tuengominh/esp32-dragon/esp32-dragon/kicad/ESP32-sensor/ESP32-sensor.kicad_pcb

## KiCad design esp32-dragon/kicad/ESP32-sensor/ESP32-sensor.kicad_pcb (2020-11-24)

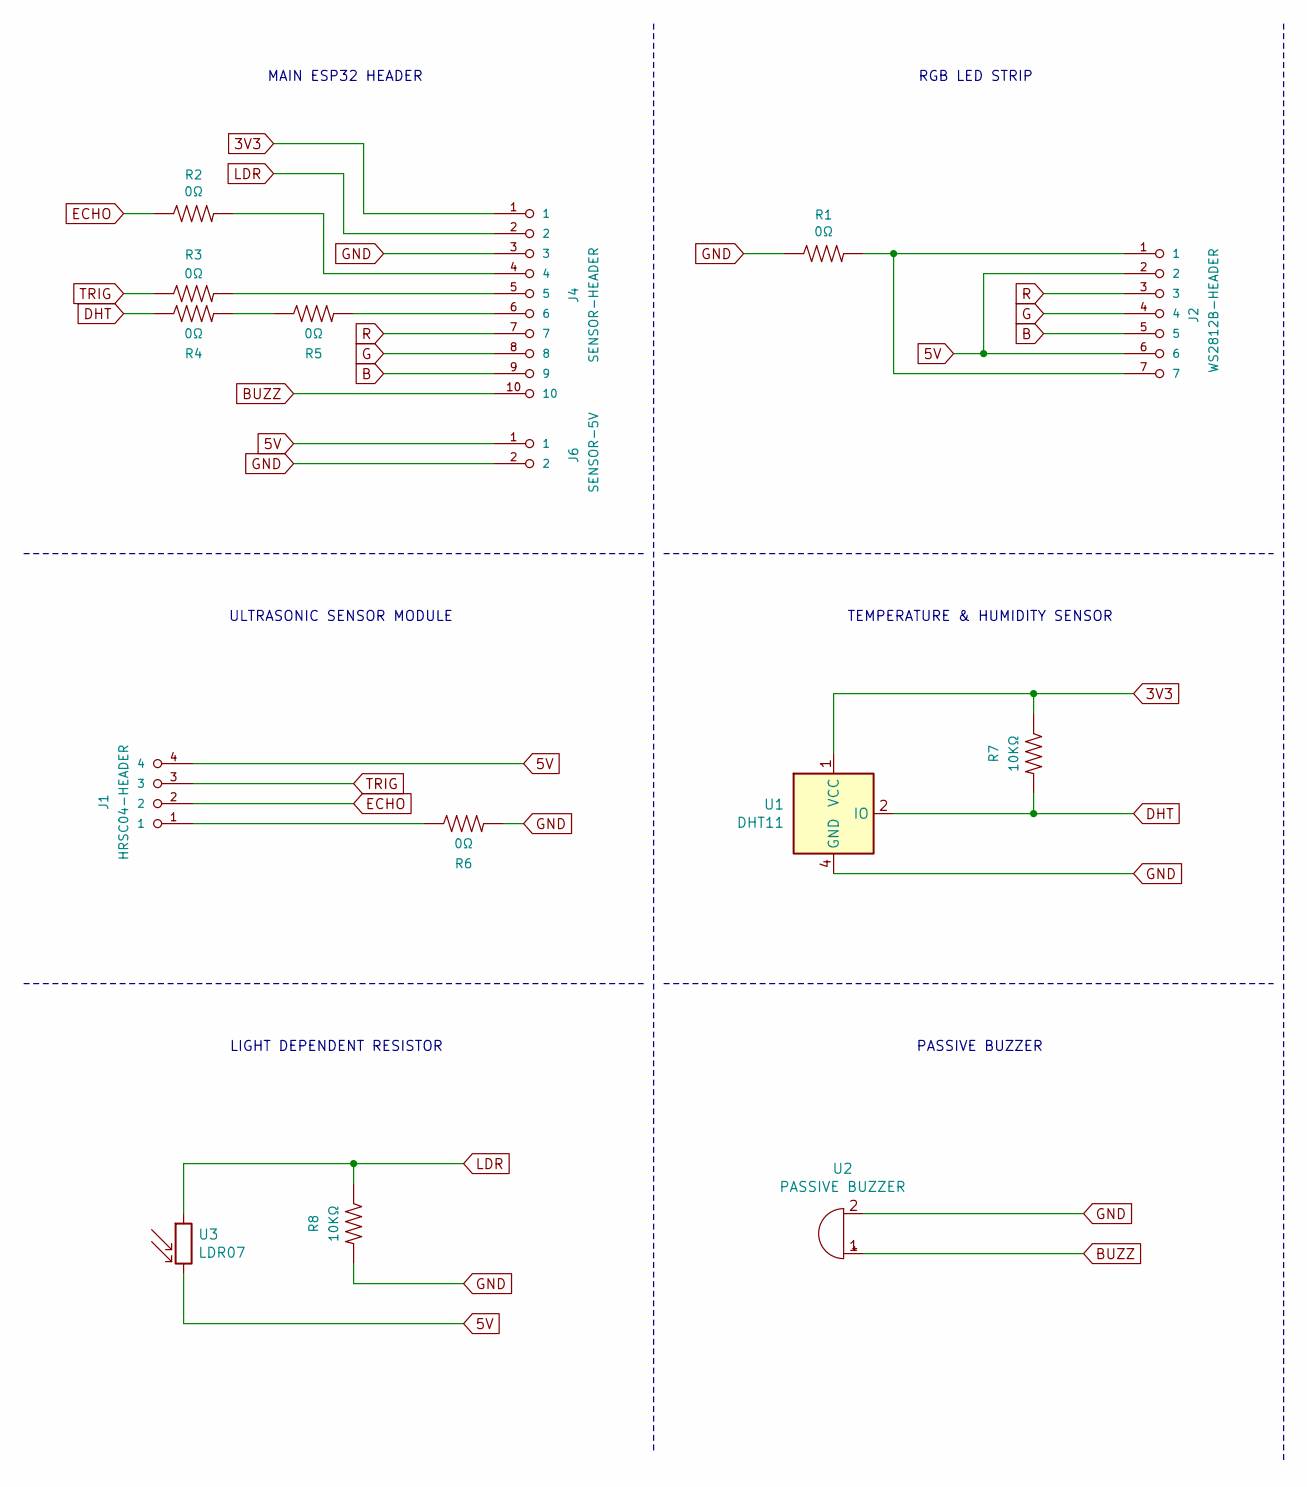
[picture p1: schematic ESP32-sensor.sch]

Parts:
J1: HRSC04-HEADER; fab-1X04
J2: WS2812B-HEADER; fab-1X07
J4: SENSOR-HEADER; fab-1X10
J6: SENSOR-5V; fab-1X02
R1, R2, R3, R4, R5, R6: 0Ω; fab-R1206FAB
R7, R8: 10KΩ; fab-R1206FAB
U1: DHT11; Aosong_DHT11_5.5x12.0_P2.54mm
U2: PASSIVE BUZZER; Buzzer_12x9.5RM7.6
U3: LDR07; R_LDR_5.1x4.3mm_P3.4mm_Vertical

Connections:
3V3: J4.1, R7.1, U1.1 (VCC)
5V: J1.4, J2.2, J2.6, J6.1, U3.2
B: J2.5, J4.9
BUZZ: J4.10, U2.1 (-)
DHT: R4.1, R7.2, U1.2 (IO)
ECHO: J1.2, R2.1
G: J2.4, J4.8
GND: J4.3, J6.2, R1.1, R6.2, R8.2, U1.4 (GND), U2.2 (+)
LDR: J4.2, R8.1, U3.1
unnamed: J1.1, R6.1
unnamed: J2.1, J2.7, R1.2
unnamed: J4.4, R2.2
unnamed: J4.5, R3.2
unnamed: J4.6, R5.2
unnamed: R4.2, R5.1
R: J2.3, J4.7
TRIG: J1.3, R3.1

Notes on the sheet:
MAIN ESP32 HEADER
RGB LED STRIP
ULTRASONIC SENSOR MODULE
TEMPERATURE & HUMIDITY SENSOR
PASSIVE BUZZER
LIGHT DEPENDENT RESISTOR

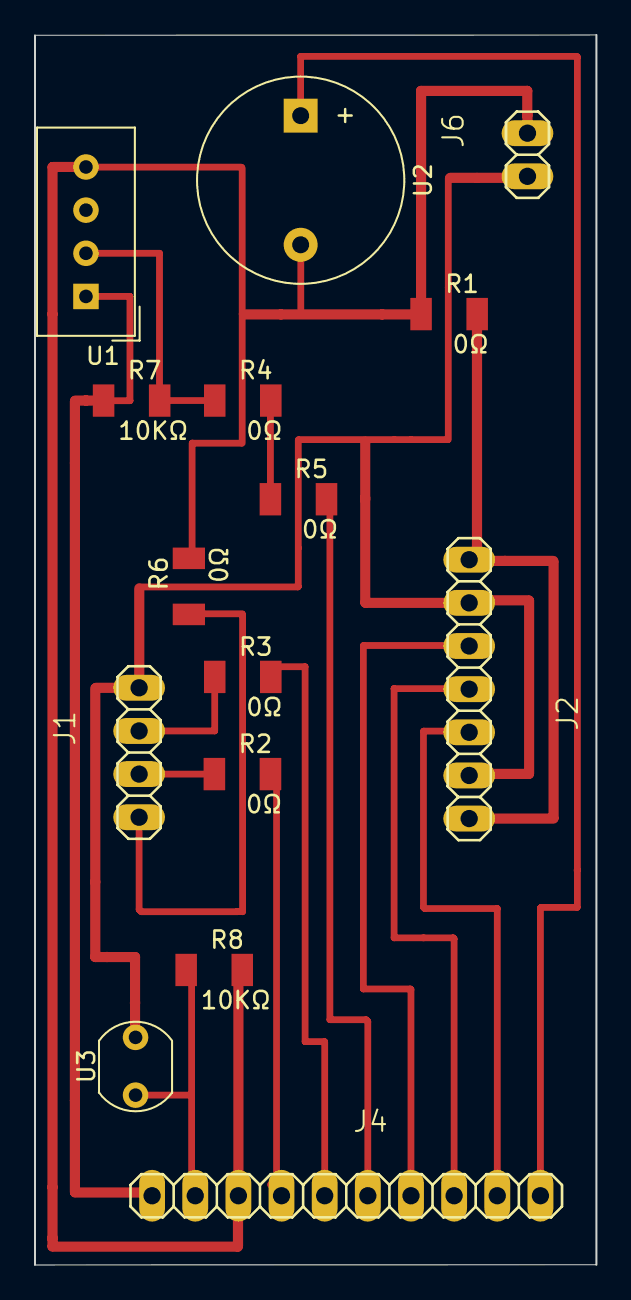
[picture p2: board ESP32-sensor.kicad_pcb from above]

Board: 2 copper layers, 33.1 x 72.4 mm, 15 parts (0 on the bottom side), 17 nets.
