tuengominh/esp32-dragon/esp32-dragon/kicad/ESP8266/ESP8266.kicad_pcb

## KiCad design esp32-dragon/kicad/ESP8266/ESP8266.kicad_pcb (2020-11-24)

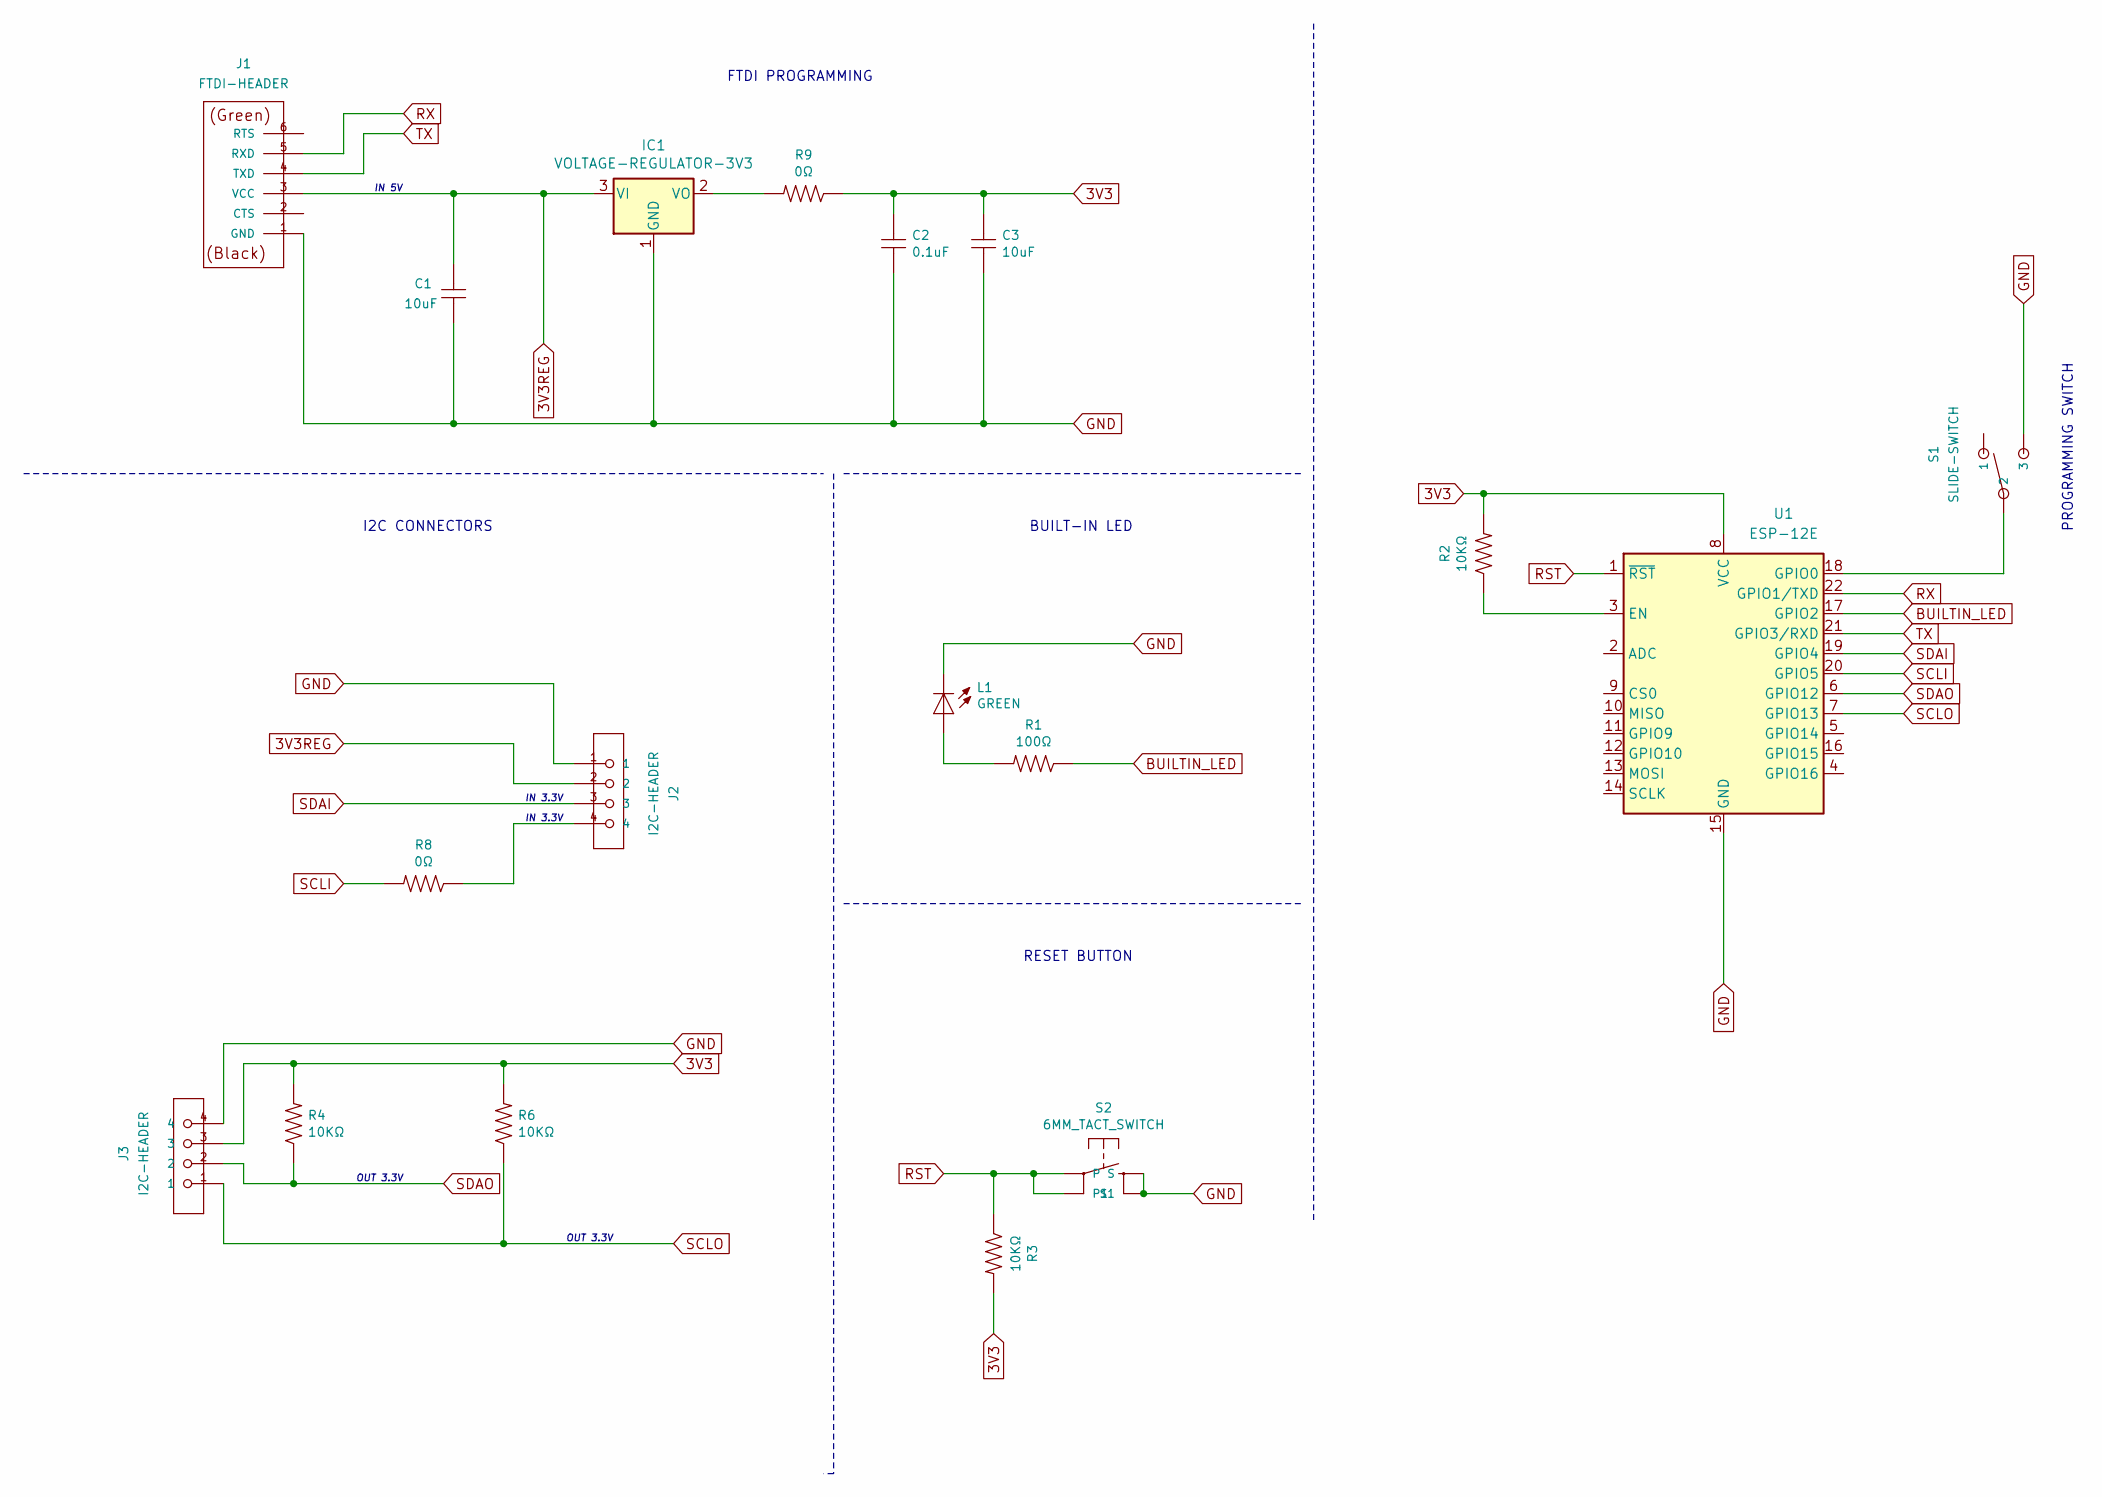
[picture p3: schematic ESP8266.sch]

Parts:
C1, C3: 10uF; fab-C1206FAB
C2: 0.1uF; fab-C1206FAB
IC1: VOLTAGE-REGULATOR-3V3; fab-SOT223
J1: FTDI-HEADER; fab-1X06SMD
J2, J3: I2C-HEADER; fab-1X04SMD
L1: GREEN; fab-LED1206FAB
R1: 100Ω; fab-R1206FAB
R2, R3, R4, R6: 10KΩ; fab-R1206FAB
R8, R9: 0Ω; fab-R1206FAB
S1: SLIDE-SWITCH; fab-AYZ0102AGRLC
S2: 6MM_TACT_SWITCH; fab-6MM_SWITCH
U1: ESP-12E

Connections:
3V3: C2.1, C3.1, J3.3, R2.2, R3.2, R4.2, R6.2, R9.1, U1.8 (VCC)
3V3REG: C1.1, IC1.3 (VI), J1.3 (VCC), J2.2
BUILTIN_LED: R1.1, U1.17 (GPIO2)
GND: C1.2, C2.2, C3.2, IC1.1 (GND), J1.1 (GND), J2.1, J3.4, L1.2 (C), S1.3, S2.3 (S), S2.4 (S1), U1.15 (GND)
unnamed: IC1.2 (VO), R9.2
unnamed: J2.4, R8.1
unnamed: L1.1 (A), R1.2
unnamed: R2.1, U1.3 (EN)
unnamed: S1.2, U1.18 (GPIO0)
RST: R3.1, S2.1, S2.2 (P1), U1.1 (~RST)
RX: J1.5 (RXD), U1.22 (GPIO1/TXD)
SCLI: R8.2, U1.20 (GPIO5)
SCLO: J3.1, R6.1, U1.7 (GPIO13)
SDAI: J2.3, U1.19 (GPIO4)
SDAO: J3.2, R4.1, U1.6 (GPIO12)
TX: J1.4 (TXD), U1.21 (GPIO3/RXD)

Notes on the sheet:
FTDI PROGRAMMING
IN 5V
RESET BUTTON
BUILT-IN LED
OUT 3.3V
I2C CONNECTORS
PROGRAMMING SWITCH
IN 3.3V

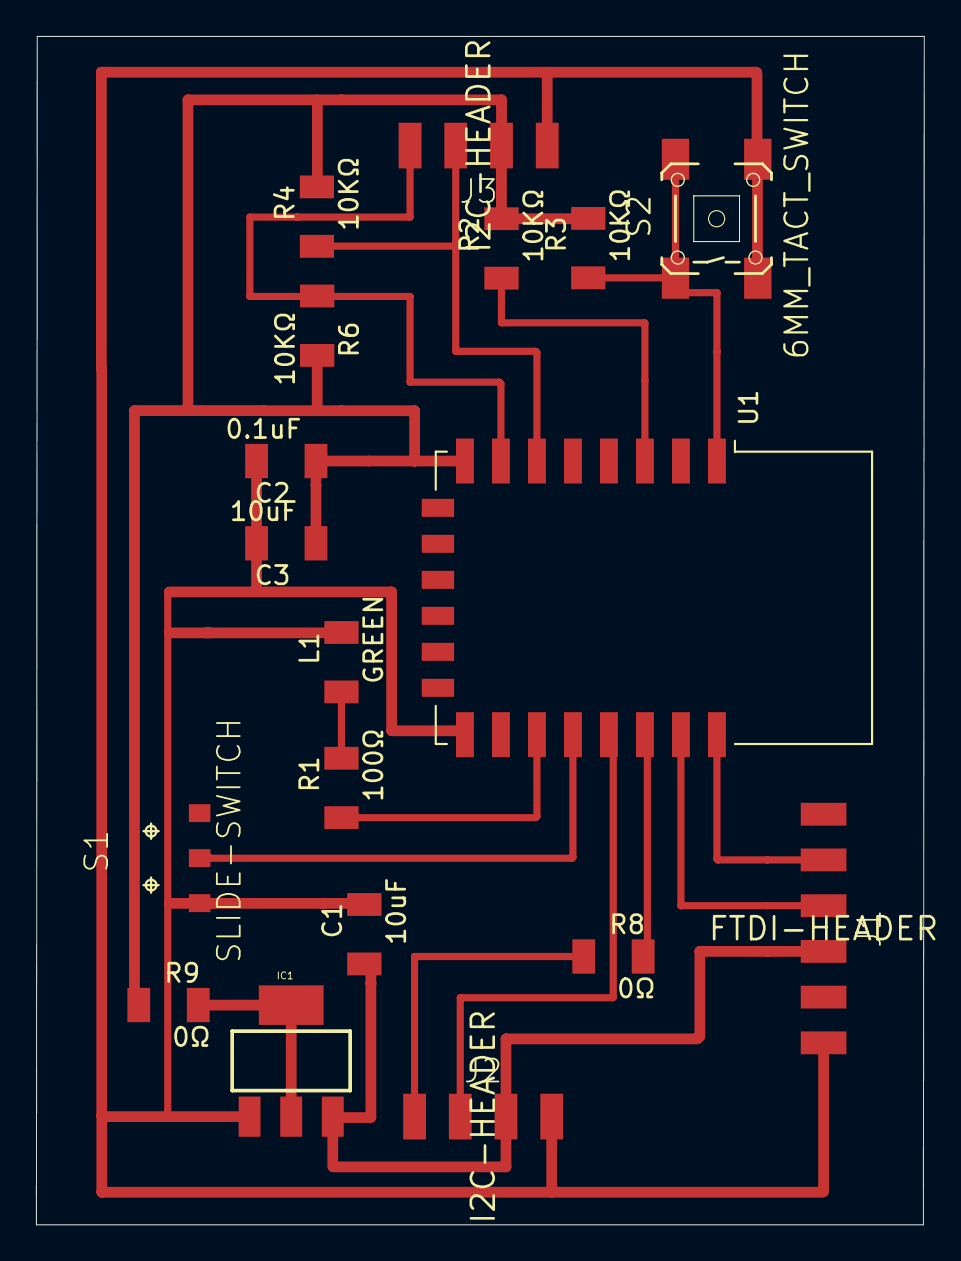
[picture p4: board ESP8266.kicad_pcb from above]

Board: 2 copper layers, 49.3 x 66.0 mm, 18 parts (0 on the bottom side), 16 nets.
