tuengominh/esp32-dragon/esp32-dragon/kicad/ESP32-motor/ESP32-motor.kicad_pcb

## KiCad design esp32-dragon/kicad/ESP32-motor/ESP32-motor.kicad_pcb (2020-11-24)

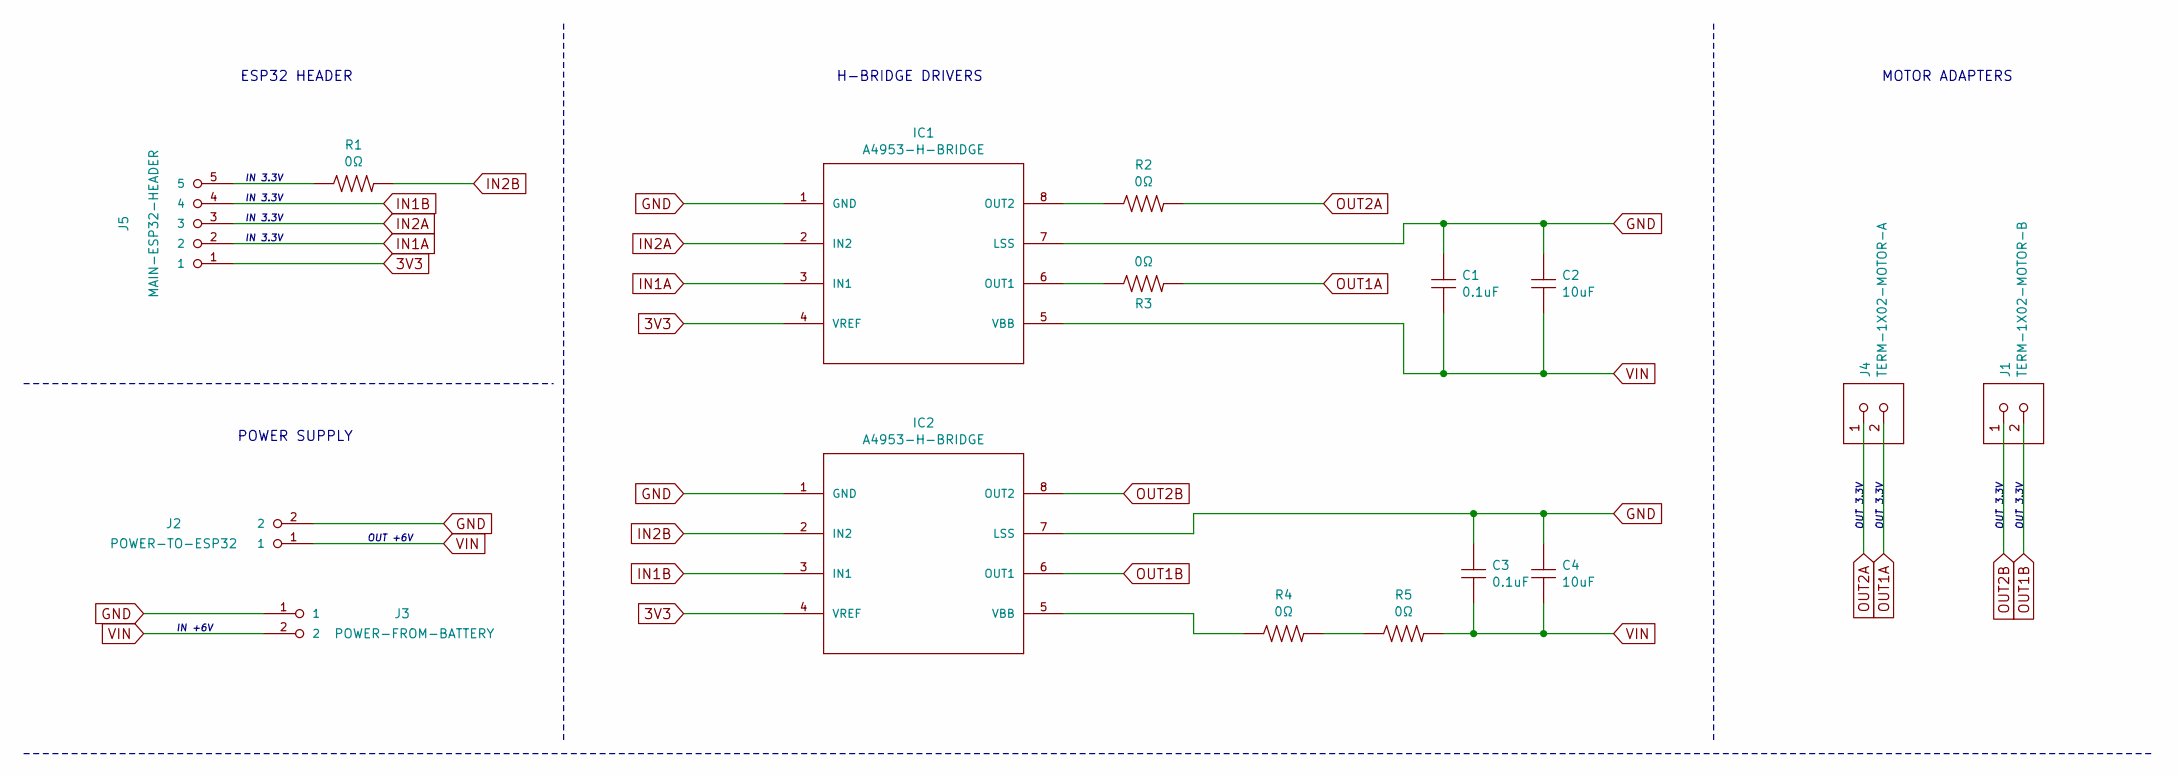
[picture p5: schematic ESP32-motor.sch]

Parts:
C1, C3: 0.1uF; fab-C1206FAB
C2, C4: 10uF; fab-C1206FAB
IC1, IC2: A4953-H-BRIDGE; fab-SOIC8
J1: TERM-1X02-MOTOR-B; fab-ED555DS-2DS
J2: POWER-TO-ESP32; fab-1X02
J3: POWER-FROM-BATTERY; HW2-SMD-2.0-90D
J4: TERM-1X02-MOTOR-A; fab-ED555DS-2DS
J5: MAIN-ESP32-HEADER; fab-1X05
R1, R2, R3, R4, R5: 0Ω; fab-R1206FAB

Connections:
3V3: IC1.4 (VREF), IC2.4 (VREF), J5.1
GND: C1.2, C2.2, C3.2, C4.2, IC1.1 (GND), IC1.7 (LSS), IC2.1 (GND), IC2.7 (LSS), J2.2, J3.1
IN1A: IC1.3 (IN1), J5.2
IN1B: IC2.3 (IN1), J5.4
IN2A: IC1.2 (IN2), J5.3
IN2B: IC2.2 (IN2), R1.2
unnamed: IC1.6 (OUT1), R3.1
unnamed: IC1.8 (OUT2), R2.1
unnamed: IC2.5 (VBB), R4.1
unnamed: J5.5, R1.1
unnamed: R4.2, R5.1
OUT1A: J4.2, R3.2
OUT1B: IC2.6 (OUT1), J1.2
OUT2A: J4.1, R2.2
OUT2B: IC2.8 (OUT2), J1.1
VIN: C1.1, C2.1, C3.1, C4.1, IC1.5 (VBB), J2.1, J3.2, R5.2

Notes on the sheet:
ESP32 HEADER
POWER SUPPLY
H-BRIDGE DRIVERS
MOTOR ADAPTERS
OUT +6V
IN +6V
IN 3.3V
OUT 3.3V

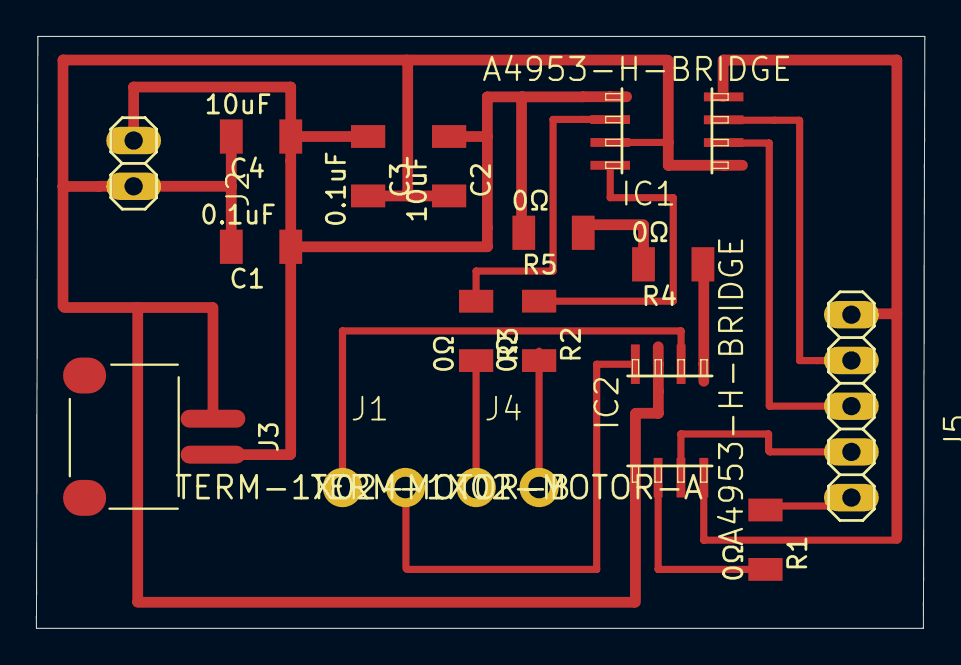
[picture p6: board ESP32-motor.kicad_pcb from above]

Board: 2 copper layers, 49.4 x 32.9 mm, 16 parts (0 on the bottom side), 16 nets.
