tuengominh/esp32-dragon/esp32-dragon/kicad/ESP32-v3/ESP32-main.kicad_pcb

## KiCad design esp32-dragon/kicad/ESP32-v3/ESP32-main.kicad_pcb (2020-11-24)

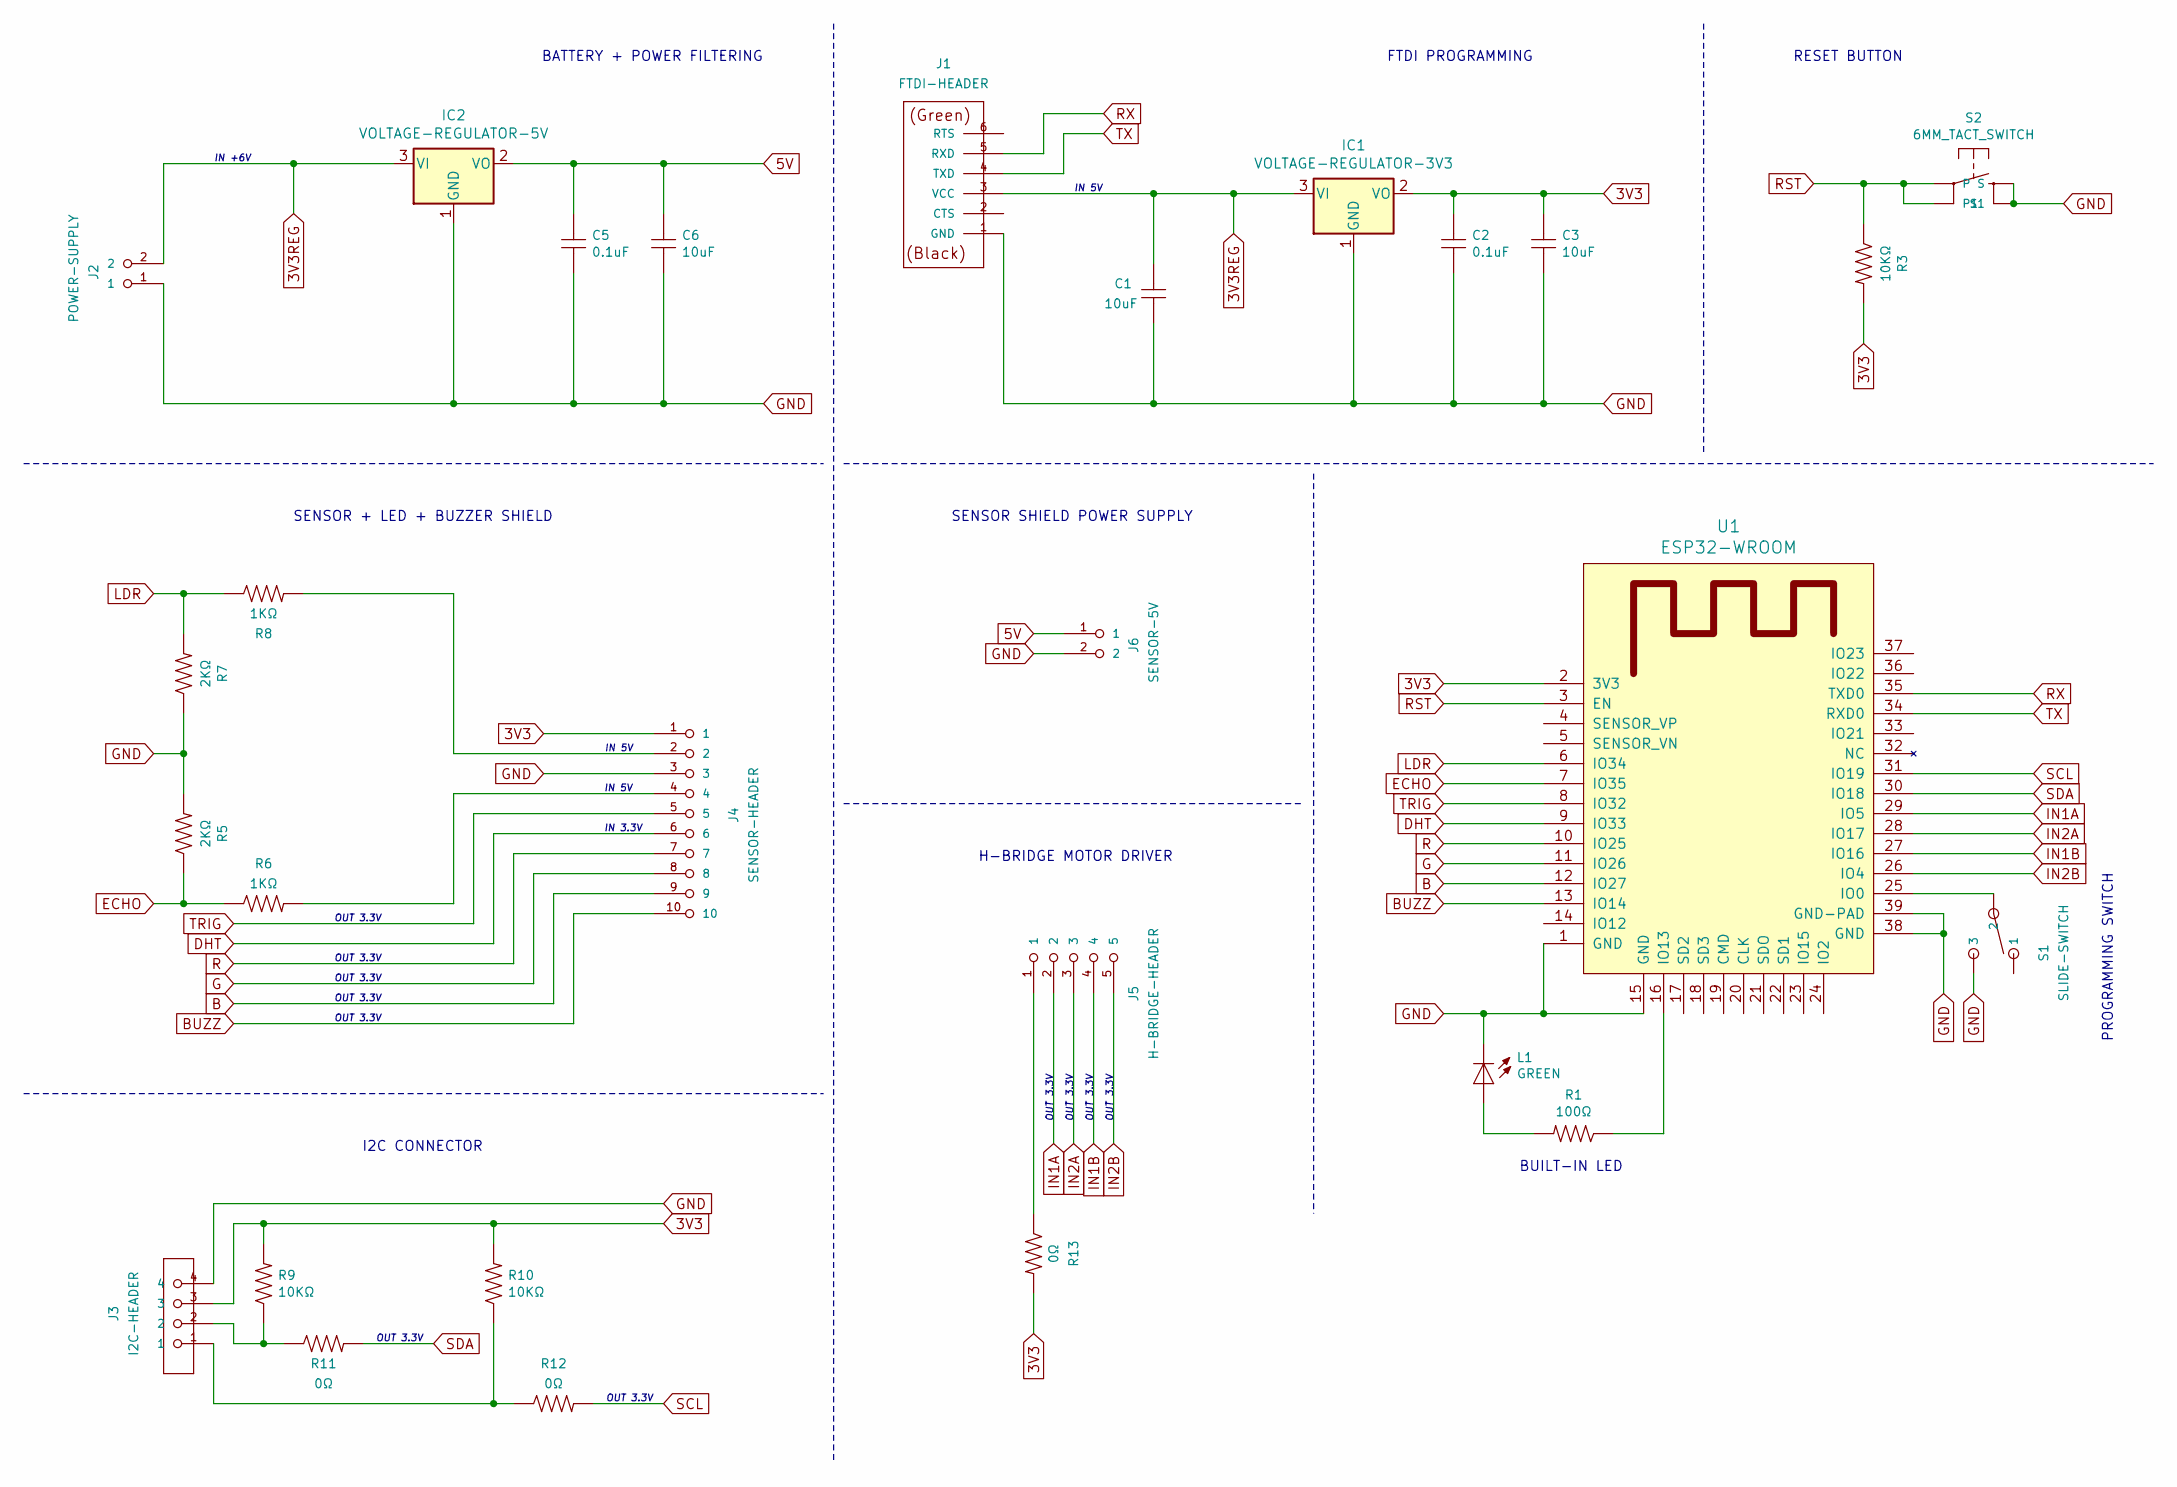
[picture p7: schematic ESP32-main.sch]

Parts:
C1, C3, C6: 10uF; fab-C1206FAB
C2, C5: 0.1uF; fab-C1206FAB
IC1: VOLTAGE-REGULATOR-3V3; fab-SOT223
IC2: VOLTAGE-REGULATOR-5V; fab-SOT223
J1: FTDI-HEADER; fab-1X06SMD
J2: POWER-SUPPLY; fab-1X02
J3: I2C-HEADER; fab-1X04SMD
J4: SENSOR-HEADER; fab-1X10
J5: H-BRIDGE-HEADER; fab-1X05
J6: SENSOR-5V; fab-1X02
L1: GREEN; fab-LED1206FAB
R1: 100Ω; fab-R1206FAB
R3, R9, R10: 10KΩ; fab-R1206FAB
R5, R7: 2KΩ; fab-R1206FAB
R6, R8: 1KΩ; fab-R1206FAB
R11, R12, R13: 0Ω; fab-R1206FAB
S1: SLIDE-SWITCH; fab-AYZ0102AGRLC
S2: 6MM_TACT_SWITCH; fab-6MM_SWITCH
U1: ESP32-WROOM; ESP32-WROOM_FAB

Connections:
3V3: C2.1, C3.1, IC1.2 (VO), J3.3, J4.1, R3.2, R9.2, R10.2, R13.2, U1.2 (3V3)
3V3REG: C1.1, IC1.3 (VI), IC2.3 (VI), J1.3 (VCC), J2.2
5V: C5.1, C6.1, IC2.2 (VO), J6.1
B: J4.9, U1.12 (IO27)
BUZZ: J4.10, U1.13 (IO14)
DHT: J4.6, U1.9 (IO33)
ECHO: R5.1, R6.1, U1.7 (IO35)
G: J4.8, U1.11 (IO26)
GND: C1.2, C2.2, C3.2, C5.2, C6.2, IC1.1 (GND), IC2.1 (GND), J1.1 (GND), J2.1, J3.4, J4.3, J6.2, L1.2 (C), R5.2, R7.1, S1.3, S2.3 (S), S2.4 (S1), U1.1 (GND), U1.15 (GND), U1.38 (GND), U1.39 (GND-PAD)
IN1A: J5.2, U1.29 (IO5)
IN1B: J5.4, U1.27 (IO16)
IN2A: J5.3, U1.28 (IO17)
IN2B: J5.5, U1.26 (IO4)
LDR: R7.2, R8.1, U1.6 (IO34)
unnamed: J3.1, R10.1, R12.1
unnamed: J3.2, R9.1, R11.1
unnamed: J4.2, R8.2
unnamed: J4.4, R6.2
unnamed: J5.1, R13.1
unnamed: L1.1 (A), R1.2
unnamed: R1.1, U1.16 (IO13)
unnamed: S1.2, U1.25 (IO0)
R: J4.7, U1.10 (IO25)
RST: R3.1, S2.1, S2.2 (P1), U1.3 (EN)
RX: J1.5 (RXD), U1.35 (TXD0)
SCL: R12.2, U1.31 (IO19)
SDA: R11.2, U1.30 (IO18)
TRIG: J4.5, U1.8 (IO32)
TX: J1.4 (TXD), U1.34 (RXD0)

Notes on the sheet:
FTDI PROGRAMMING
IN 5V
BATTERY + POWER FILTERING
RESET BUTTON
I2C CONNECTOR
PROGRAMMING SWITCH
BUILT-IN LED
H-BRIDGE MOTOR DRIVER
OUT 3.3V
IN 3.3V
SENSOR + LED + BUZZER SHIELD
SENSOR SHIELD POWER SUPPLY
IN +6V

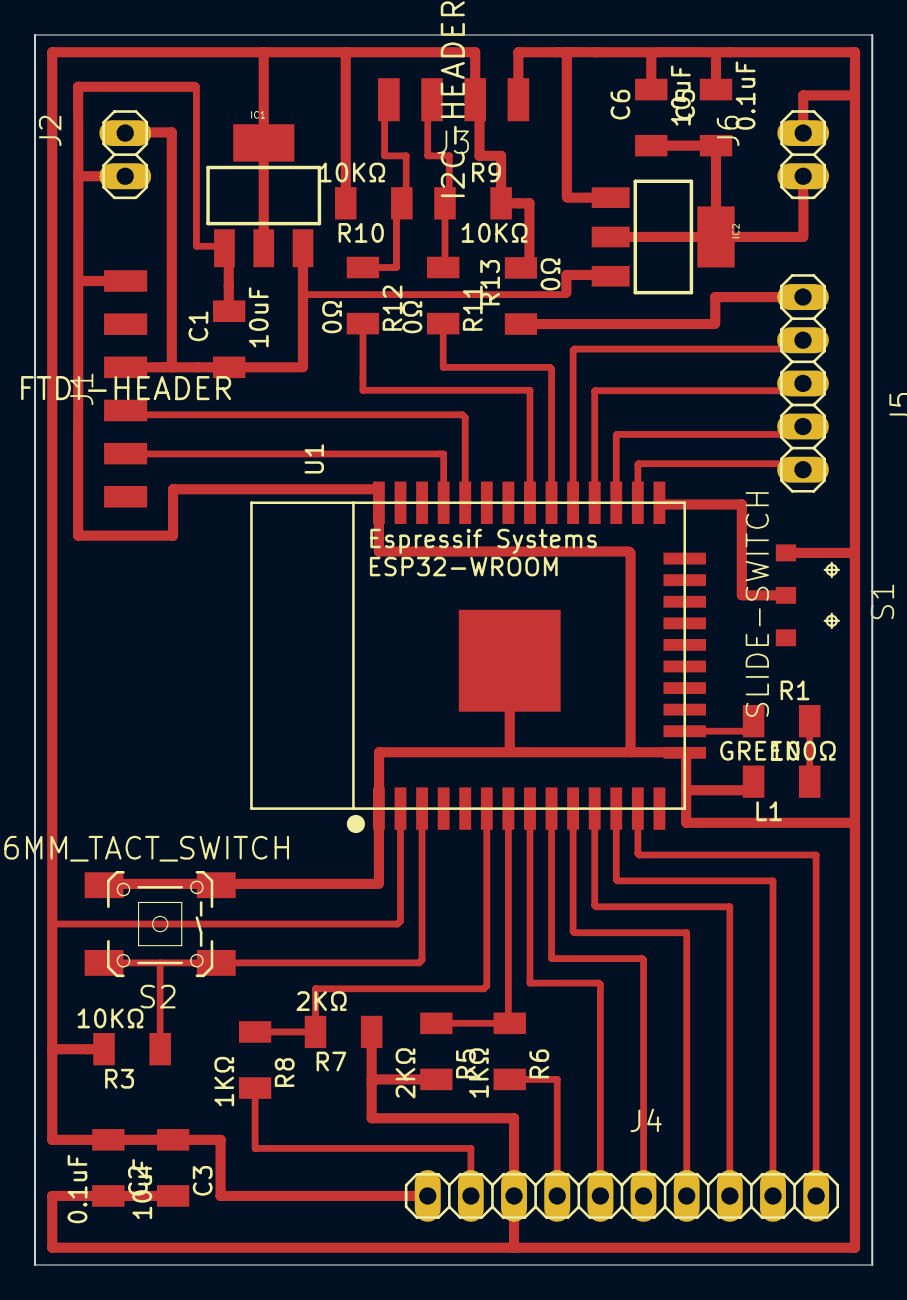
[picture p8: board ESP32-main.kicad_pcb from above]

Board: 2 copper layers, 49.3 x 72.4 mm, 28 parts (0 on the bottom side), 29 nets.
